faberquisque/syringe-pump/Cableado.pdf

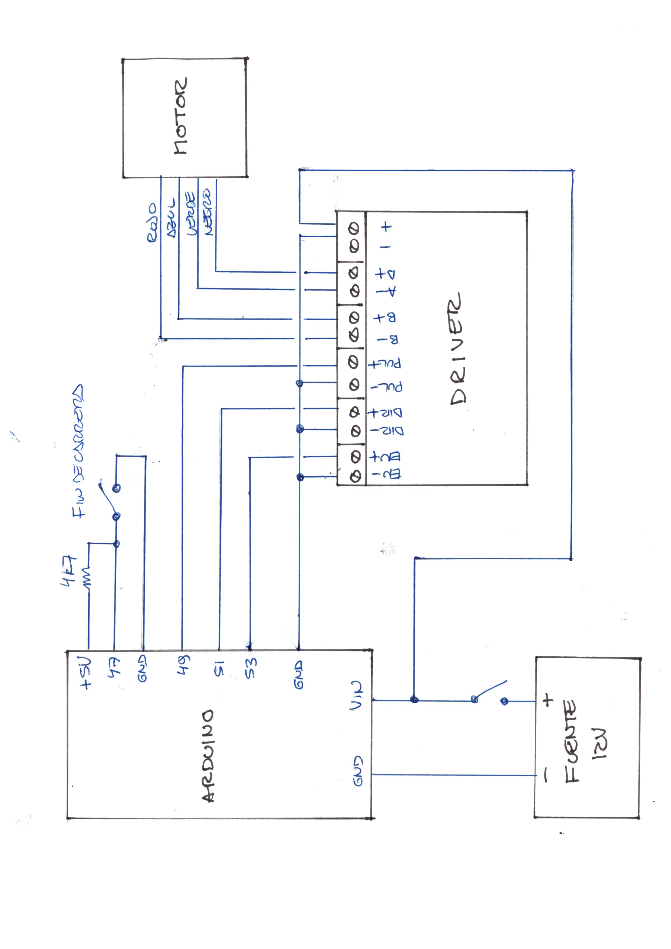
[picture p1: page 1]
