faberquisque/syringe-pump/solid works parts and assembly/SW-case arduino syringe pump/AssemC.SLDASM

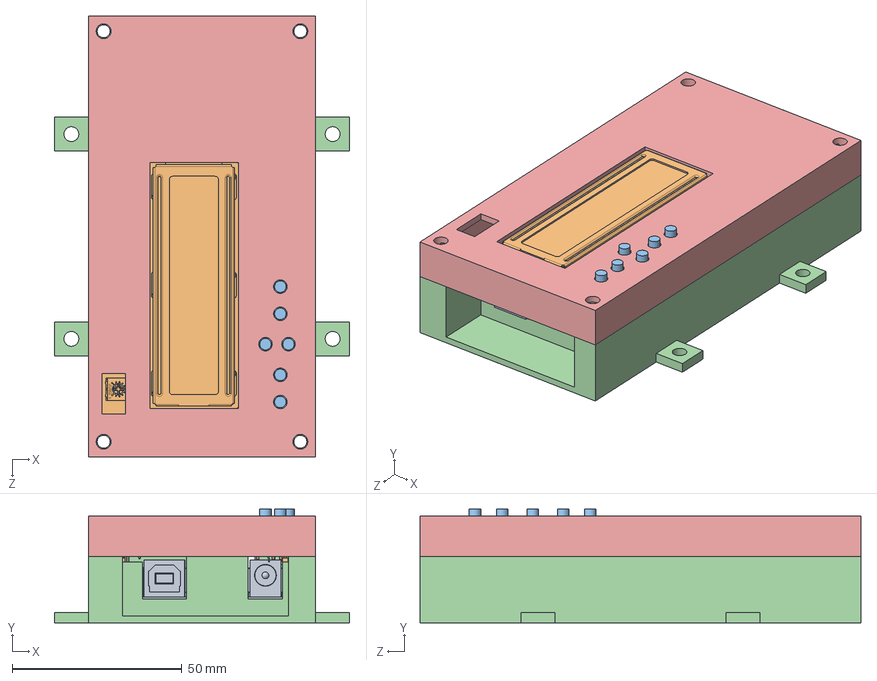
[picture p2: CAD file, 2019-10-16]
solid works parts and assembly/SW-case arduino syringe pump/AssemC.SLDASM
87.0 x 33.5 x 130.0 mm
ArduinoMega
LCD_keypad_Shield_v1-1
boton x 6
arduinocasebaseC
arduinocaseTAPAC
