faberquisque/syringe-pump/solid works parts and assembly/TR08.stp.SLDASM

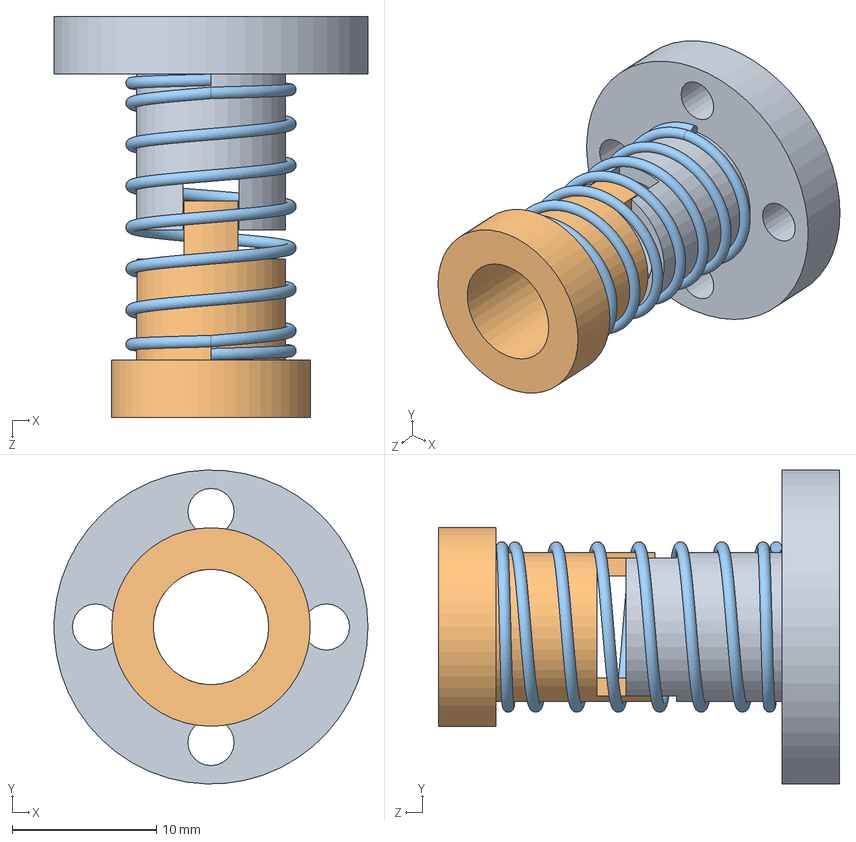
[picture p3: CAD file, 2019-10-15]
solid works parts and assembly/TR08.stp.SLDASM
21.8 x 21.7 x 27.8 mm
nakretka tr08.stp
napinacz nakretki tr8.stp
sprezyna nakretka tr 8.stp
