faberquisque/syringe-pump/solid works parts and assembly/HGW15CA (1).SLDPRT

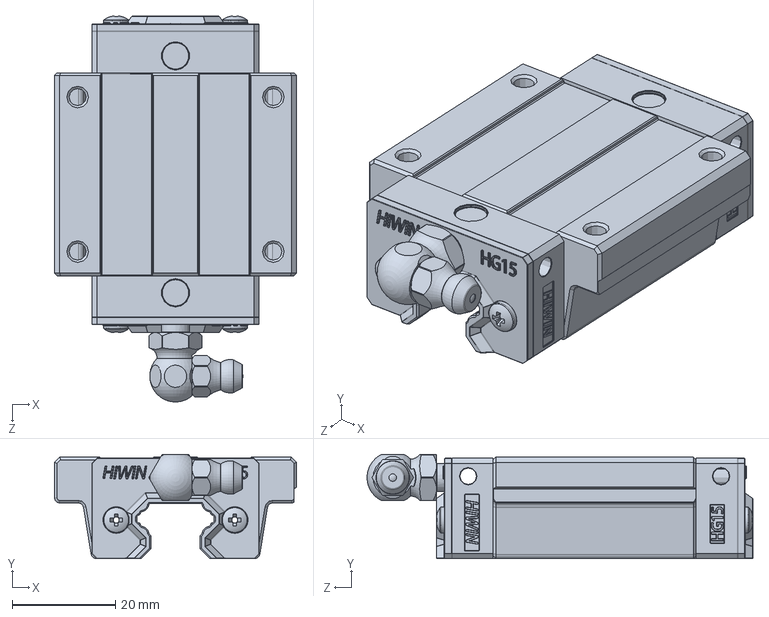
[picture p4: CAD file, 2019-10-16]
solid works parts and assembly/HGW15CA (1).SLDPRT
47.0 x 20.2 x 74.9 mm
