faberquisque/syringe-pump/solid works parts and assembly/Placa base.SLDPRT

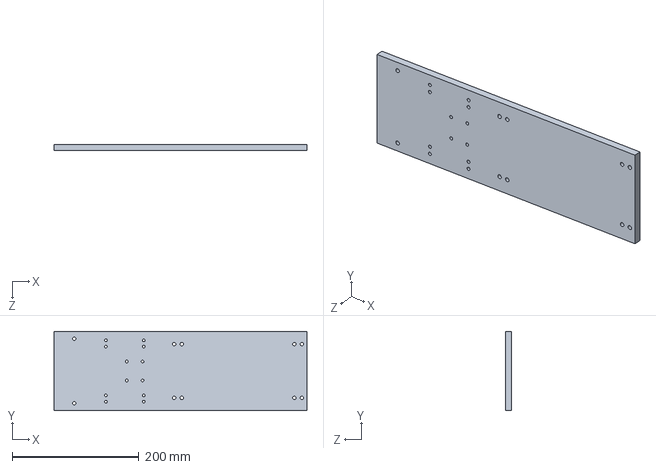
[picture p5: CAD file, 2019-10-16]
solid works parts and assembly/Placa base.SLDPRT
400.0 x 125.0 x 10.0 mm
