faberquisque/syringe-pump/solid works parts and assembly/SW-case arduino syringe pump/arduinocaseTAPAC.SLDPRT

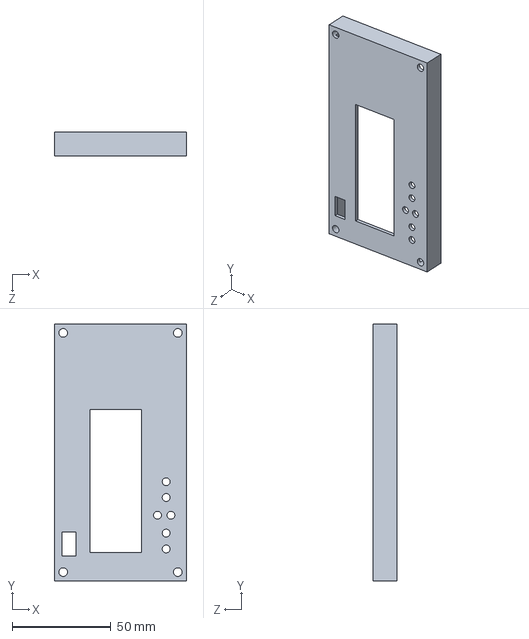
[picture p6: CAD file, 2019-10-16]
solid works parts and assembly/SW-case arduino syringe pump/arduinocaseTAPAC.SLDPRT
67.0 x 130.0 x 12.0 mm
