faberquisque/syringe-pump/solid works parts and assembly/608-2Z.SLDPRT

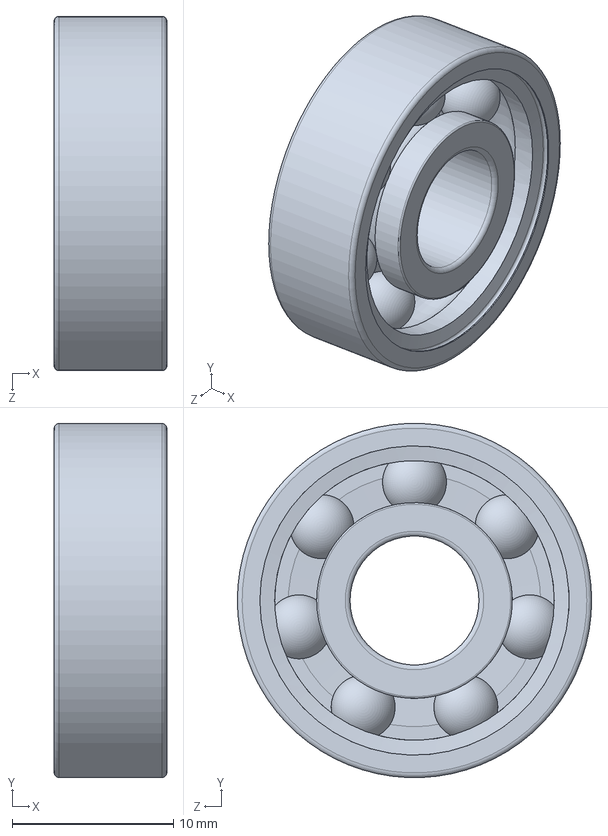
[picture p7: CAD file, 2019-10-16]
solid works parts and assembly/608-2Z.SLDPRT
7.00 x 22.0 x 22.0 mm
