faberquisque/syringe-pump/solid works parts and assembly/SW-case arduino syringe pump/arduinocasebaseC.SLDPRT

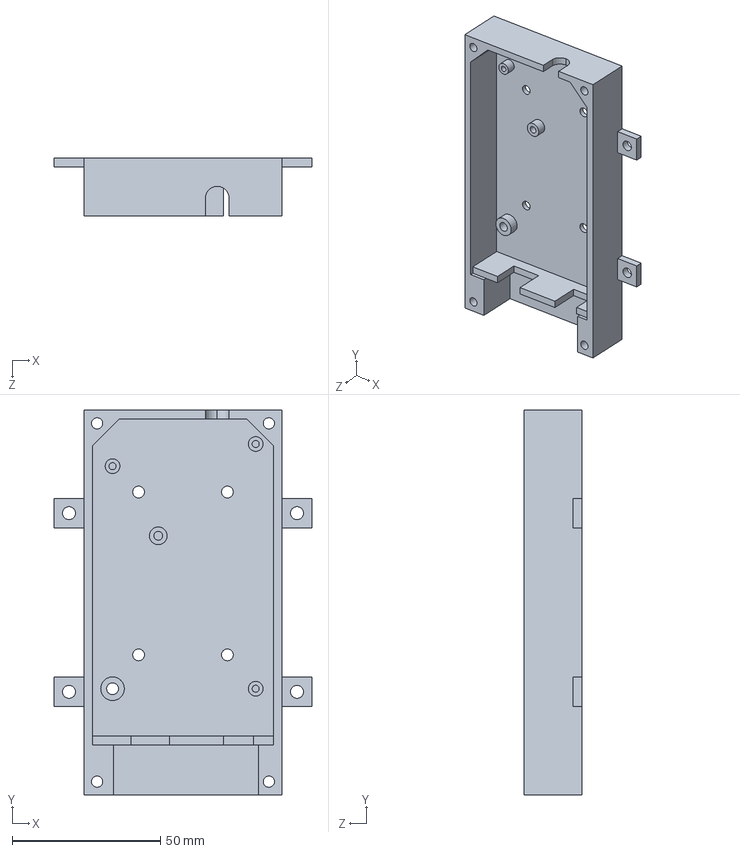
[picture p8: CAD file, 2019-10-16]
solid works parts and assembly/SW-case arduino syringe pump/arduinocasebaseC.SLDPRT
87.0 x 130.0 x 19.5 mm
