faberquisque/syringe-pump/solid works parts and assembly/pushetuerca TR8 para impresion.SLDPRT

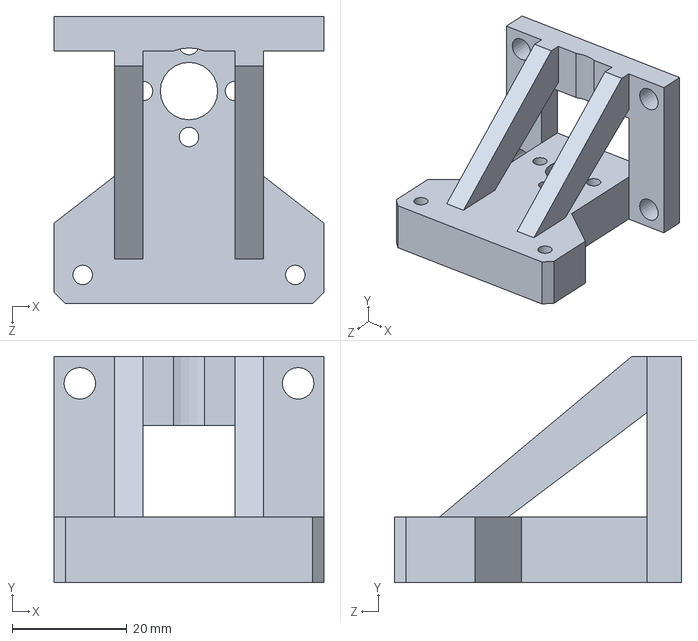
[picture p9: CAD file, 2019-10-16]
solid works parts and assembly/pushetuerca TR8 para impresion.SLDPRT
47.0 x 39.4 x 50.0 mm
