faberquisque/syringe-pump/solid works parts and assembly/SW-case arduino syringe pump/boton.SLDPRT

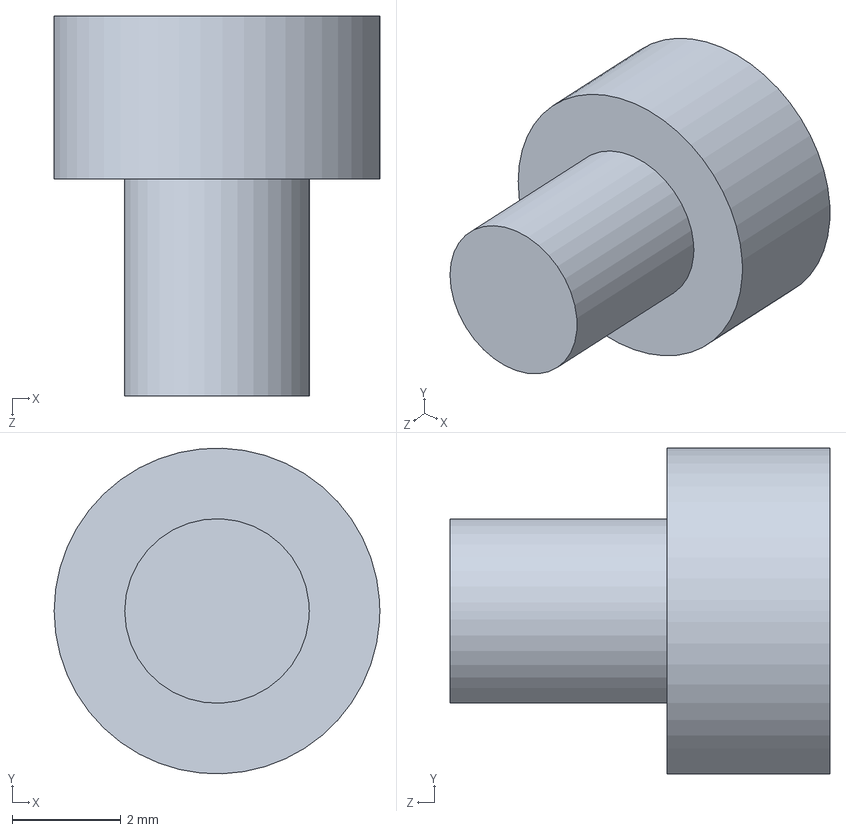
[picture p10: CAD file, 2019-10-16]
solid works parts and assembly/SW-case arduino syringe pump/boton.SLDPRT
6.00 x 6.00 x 7.00 mm
