faberquisque/syringe-pump/solid works parts and assembly/NEMA 17 Motor Mount Plate.SLDPRT

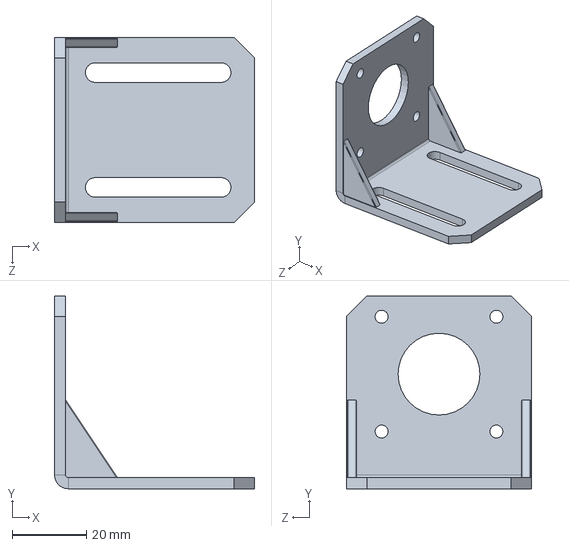
[picture p11: CAD file, 2019-10-16]
solid works parts and assembly/NEMA 17 Motor Mount Plate.SLDPRT
54.0 x 52.0 x 50.0 mm
