faberquisque/syringe-pump/solid works parts and assembly/SW-case arduino syringe pump/ArduinoMega.SLDPRT

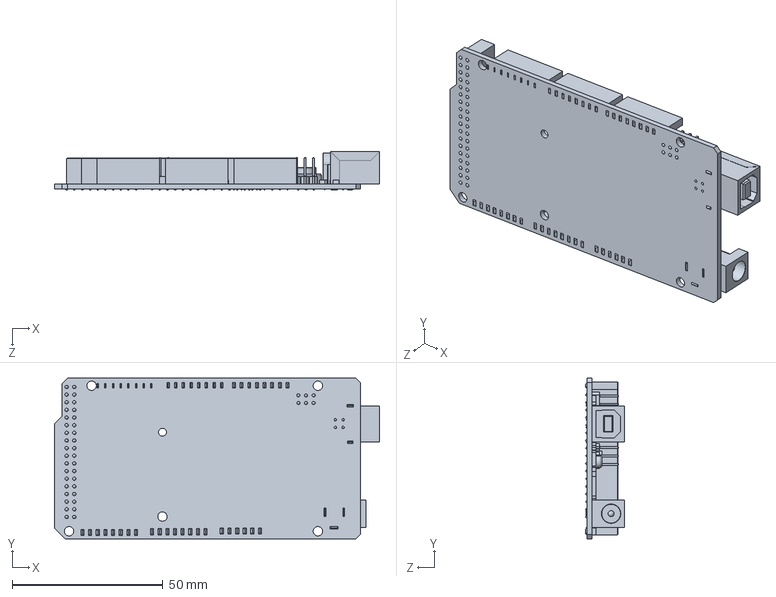
[picture p12: CAD file, 2019-10-16]
solid works parts and assembly/SW-case arduino syringe pump/ArduinoMega.SLDPRT
107.9 x 53.4 x 13.0 mm
