faberquisque/syringe-pump/solid works parts and assembly/NEMA17-PG27b.SLDPRT

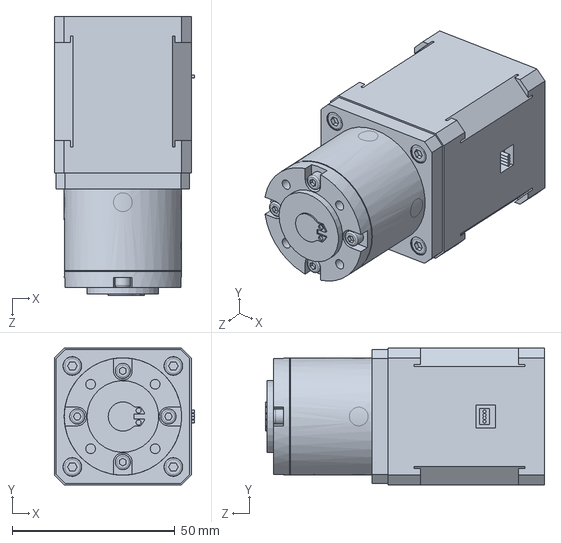
[picture p13: CAD file, 2019-10-16]
solid works parts and assembly/NEMA17-PG27b.SLDPRT
43.0 x 42.0 x 85.6 mm
