faberquisque/syringe-pump/solid works parts and assembly/soporte lado jeringa para impresion.SLDPRT

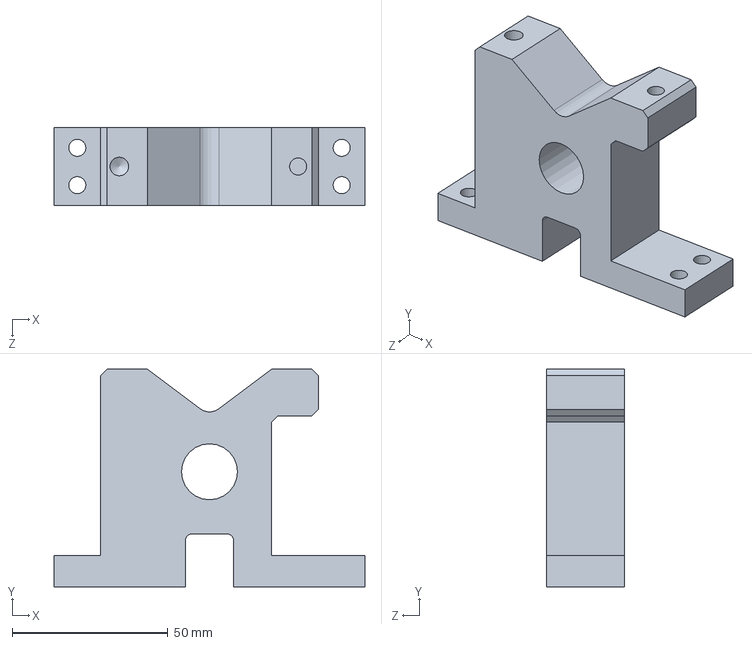
[picture p14: CAD file, 2019-10-16]
solid works parts and assembly/soporte lado jeringa para impresion.SLDPRT
100.0 x 70.0 x 25.0 mm
