faberquisque/syringe-pump/solid works parts and assembly/HGR15T-200mm.SLDPRT

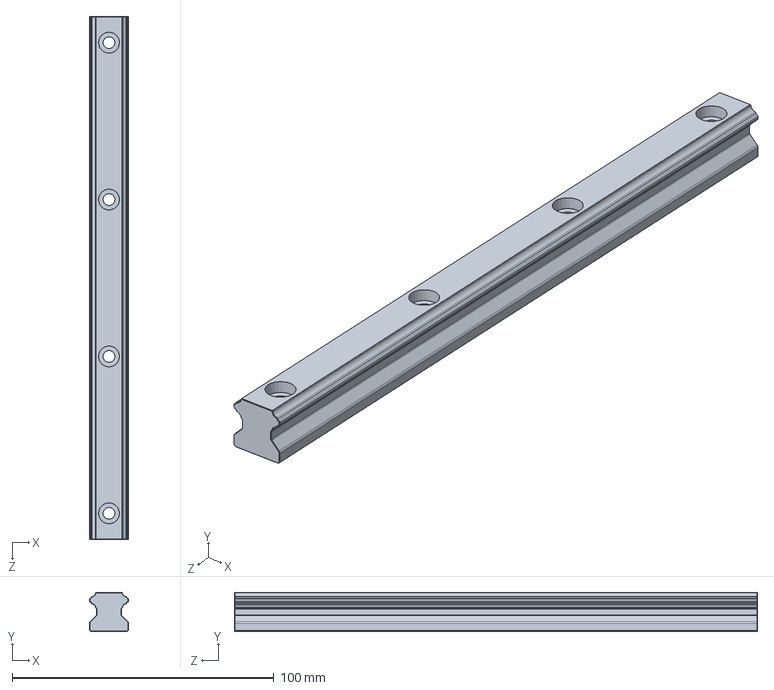
[picture p15: CAD file, 2019-10-16]
solid works parts and assembly/HGR15T-200mm.SLDPRT
15.0 x 15.0 x 200.0 mm
