faberquisque/syringe-pump/solid works parts and assembly/ejereductor.SLDPRT

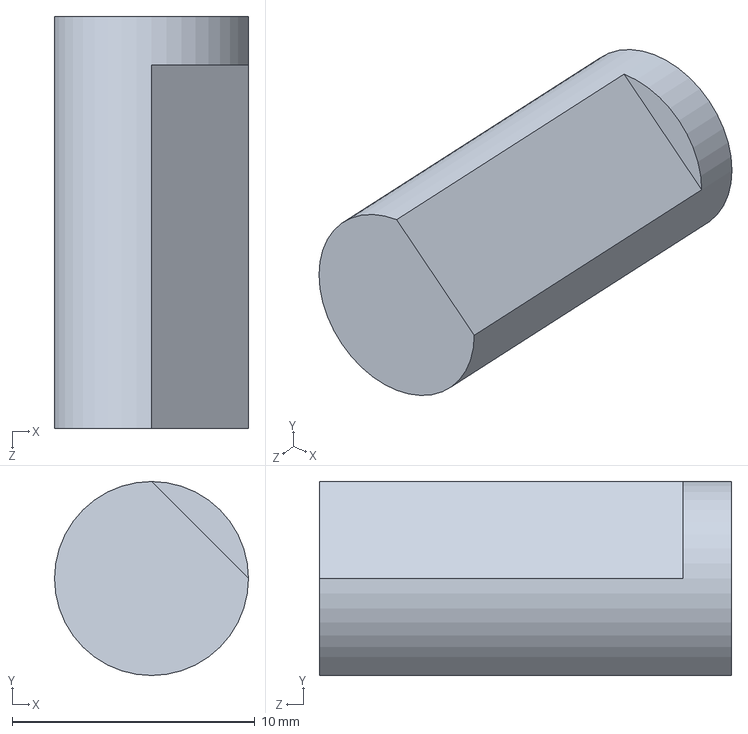
[picture p16: CAD file, 2019-10-16]
solid works parts and assembly/ejereductor.SLDPRT
8.00 x 8.00 x 17.0 mm
