faberquisque/syringe-pump/solid works parts and assembly/soporte lado motor para impresion.SLDPRT

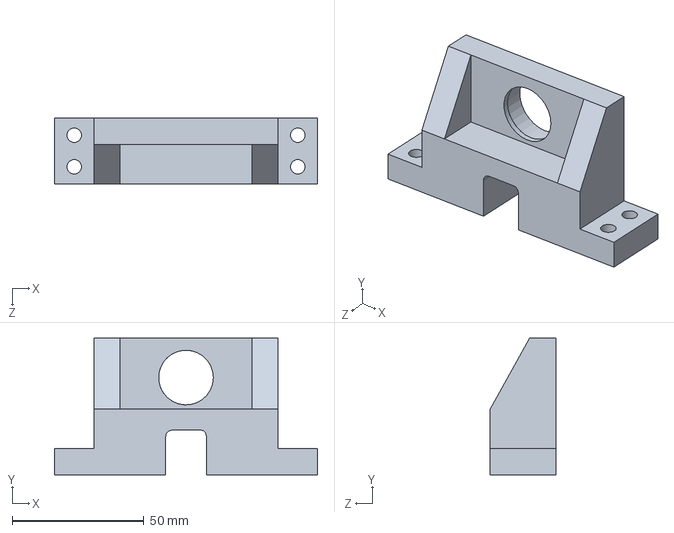
[picture p17: CAD file, 2019-10-16]
solid works parts and assembly/soporte lado motor para impresion.SLDPRT
100.0 x 52.0 x 25.0 mm
