faberquisque/syringe-pump/solid works parts and assembly/base soporte motor.SLDPRT

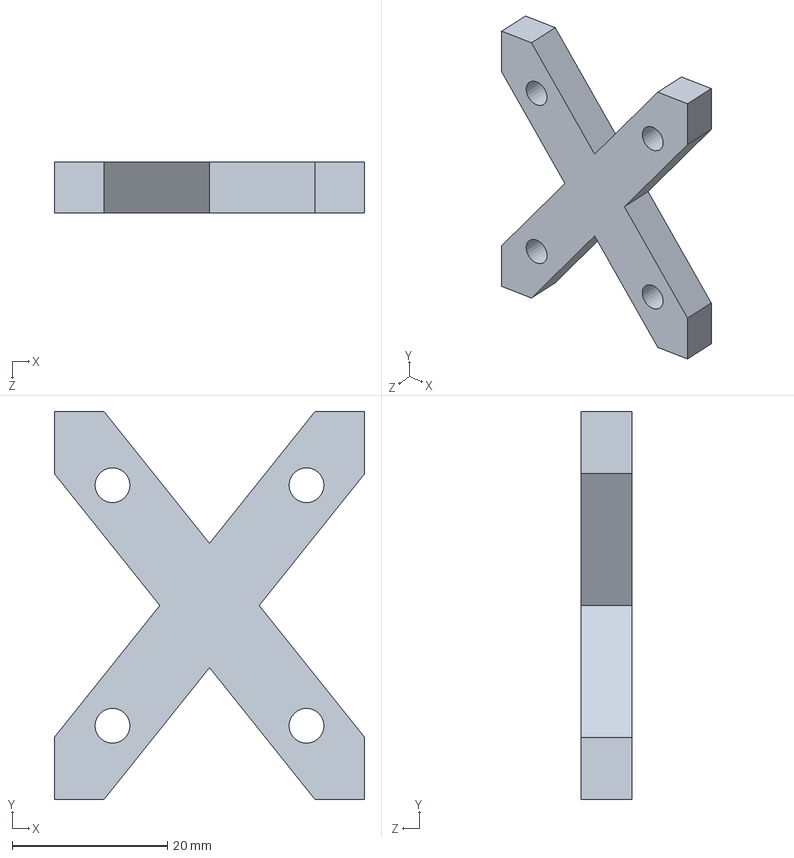
[picture p18: CAD file, 2019-10-16]
solid works parts and assembly/base soporte motor.SLDPRT
40.0 x 50.0 x 6.54 mm
