faberquisque/syringe-pump/solid works parts and assembly/trabajeringa.SLDPRT

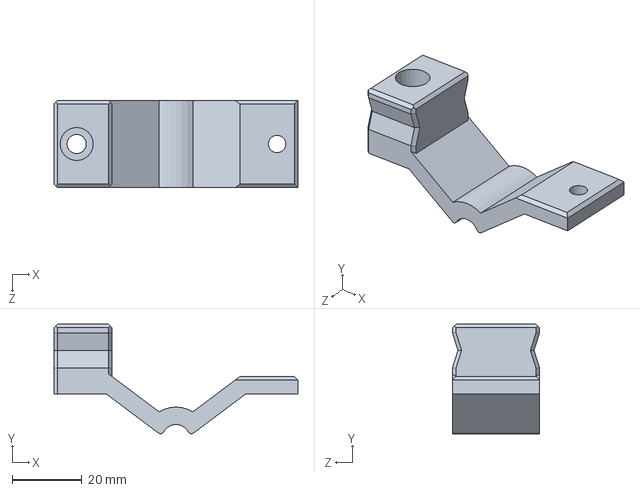
[picture p19: CAD file, 2019-10-16]
solid works parts and assembly/trabajeringa.SLDPRT
70.0 x 31.4 x 25.0 mm
