faberquisque/syringe-pump/solid works parts and assembly/HY-DIV268N-5A.step.SLDPRT

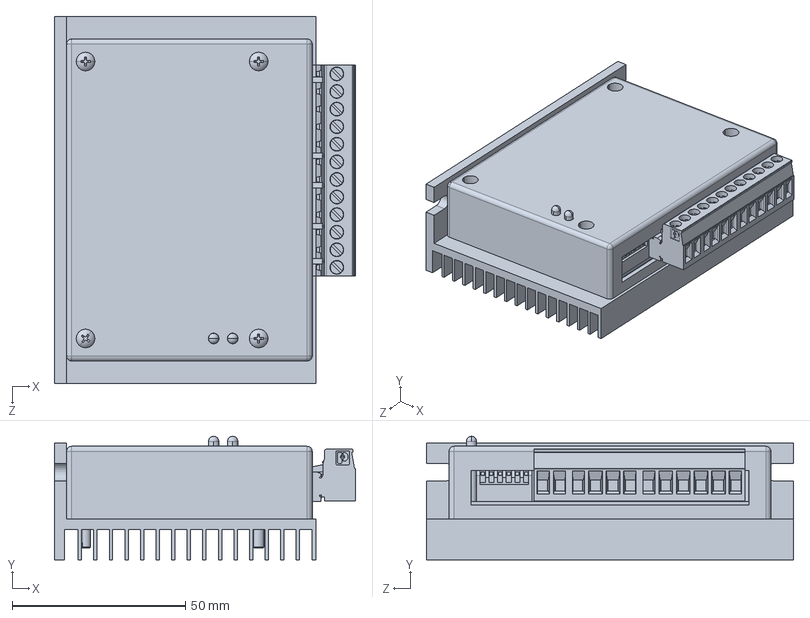
[picture p20: CAD file, 2019-10-16]
solid works parts and assembly/HY-DIV268N-5A.step.SLDPRT
87.0 x 35.7 x 106.0 mm
