faberquisque/syringe-pump/solid works parts and assembly/Pilar.SLDPRT

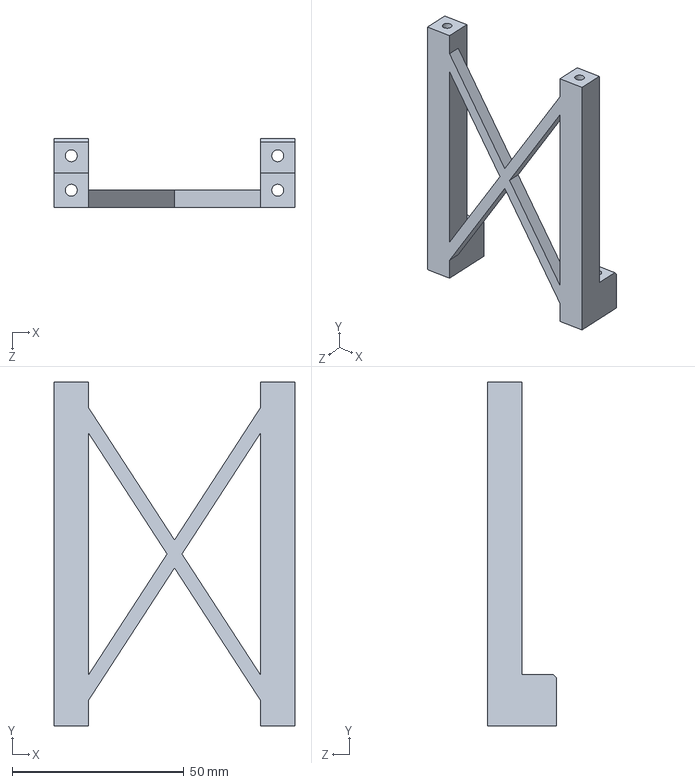
[picture p21: CAD file, 2019-10-16]
solid works parts and assembly/Pilar.SLDPRT
70.0 x 100.0 x 20.0 mm
