faberquisque/syringe-pump/(list of files, cad)

Other CAD files:
solid works parts and assembly/napinacz nakretki tr8.stp.SLDPRT
solid works parts and assembly/nakretka tr08.stp.SLDPRT
solid works parts and assembly/sprezyna nakretka tr 8.stp.SLDPRT
solid works parts and assembly/HY-DIV268N-5A.STEP
solid works parts and assembly/TR08.stp
solid works parts and assembly/9861T533_ALUMINUM HELICAL FLEXIBLE SHAFT COUPLING.STEP
solid works parts and assembly/9861T533_ALUMINUM HELICAL FLEXIBLE SHAFT COUPLING.step.SLDPRT
solid works parts and assembly/HY-DIV268N-5A.SLDPRT
solid works parts and assembly/TR08.SLDPRT
solid works parts and assembly/Trapezoidal lead screw tr8x8-4-L200mm.SLDPRT
