faberquisque/syringe-pump/Calibracion.xlsx

Sheet: Flow Rate
Volumen Jeringa (mL) | Marca | Longitud (mm) | Longitud (um) | Volumen (mL) | Volumen (uL) | Flujo min (mL/min) | Flujo máx (mL/min) | Flujo mín (uL/h) | Flujo máx (uL/h) | Flujo min (nL/min) | Flujo máx (nL/min) | Frecuencia mínima (pulso/seg) | Frecuencia máxima (pulso/paso)
0.01 | Hamilton | 48.04 | 48040 | 0.008 | 8 | 0.000015 | 0.012270 | 0.9 | 736.1990302 | 15.21477996 | 12269.98384 | 31 | 25000
1 | Rymco | 28.10 | 28100 | 0.5 | 500 | 0.001626 | 1.311054 | 97.54244161 | 78663.25936 | 1625.70736 | 1311054.323 | pasos/vuelta motor | vueltaMotor/1vueltaEje (del reductor)
3 | Terumo | 15.86 | 15860 | 1 | 1000 | 0.005761 | 4.645728 | 345.6421954 | 278743.7059 | 5760.703256 | 4645728.432 | 200 | 50.8949
5 | Coronel | 16.34 | 16340 | 2 | 2000 | 0.011183 | 9.018513 | 670.9773829 | 541110.7927 | 11182.95638 | 9018513.211 | Calibración teórica (pulsos/mm) | vuelta Eje (mm)
12 | Terumo | 30.54 | 30540 | 6 | 6000 | 0.017950 | 14.475688 | 1076.991202 | 868541.292 | 17949.85337 | 14475688.2 | 20357.96 | 8
 |  |  |  |  |  |  |  |  |  |  |  | Micro step (pulso/paso) | 16
Multiplicador |  | 16 | pulso/paso |  | 1 | Hz | RPM max (eje) |  | 25 | vuelta eje/min
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
