faberquisque/syringe-pump/solid works parts and assembly/assemblyV2.pdf

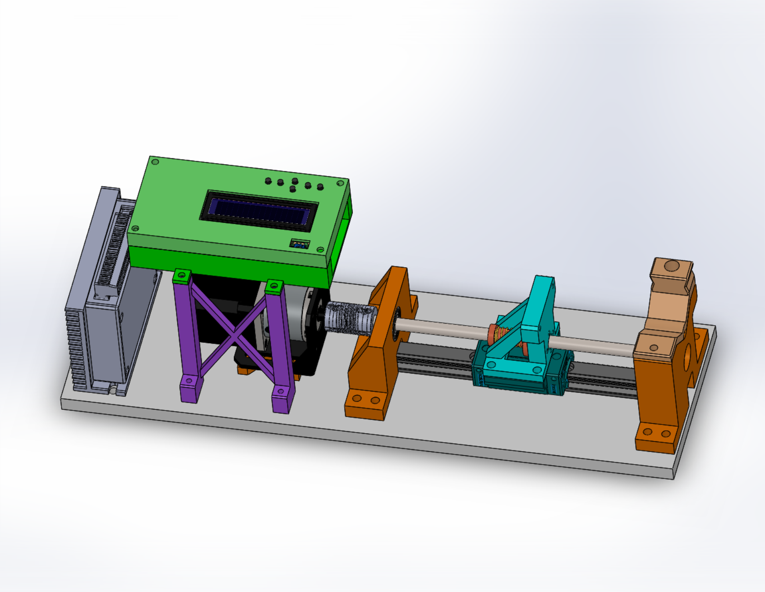
[picture p22: page 1]
