faberquisque/syringe-pump/(list of files, drawings)

Other design files:
Gráfica.opj
