faberquisque/syringe-pump/(commit log)

2019-10-15 Estado actual de 2 bombas
    [608-2Z.SLDPRT, 9861T533_ALUMINUM HELICAL FLEXIBLE SHAFT COUPLING.STEP, 9861T533_ALUMINUM HELICAL FLEXIBLE SHAFT COUPLING.step.SLDPRT, ArduinoMega.SLDPRT, AssemC.SLDASM, HGR15T-200mm.SLDPRT, HGW15CA (1).SLDPRT, HY-DIV268N-5A.STEP]
2019-10-16 .stp mal colocados: corregidos
    [608-2Z.SLDPRT, 9861T533_ALUMINUM HELICAL FLEXIBLE SHAFT COUPLING.step.SLDPRT, ArduinoMega.SLDPRT, AssemC.SLDASM, HGR15T-200mm.SLDPRT, HGW15CA (1).SLDPRT, HY-DIV268N-5A.SLDPRT, HY-DIV268N-5A.step.SLDPRT]
2019-10-17 Calculo flujo min/max
    [Flow rate.xlsx]
2019-10-18 Multiplicador 16 pulso/paso
    #define MAX_FREQ 25000
    unsigned long calibration = 20358
    [Flow rate.xlsx]
2019-10-18 Flow rate
    [Flow rate.xlsx]
2019-10-18 Calibración
    [Calibracion.xlsx]
2019-11-22 ultimo punto
    [Calibracion.xlsx]
2019-11-22 cambio excel
    [Calibracion.xlsx, Flow rate.xlsx]
2019-11-26 Calib bomba 2
    [Calibracion.xlsx]
2019-12-02 Le s. pump 2
    [Calibracion.xlsx]
2019-12-02 Compilado y carga de datos a la bomba 1
    20381 pulsos/mm
    syringeLenght 45252
    syringeVolume 3000
    [Calibracion.xlsx]
2019-12-03 Curva de calibracion bomba 1
    [Calibracion.xlsx, Gráfica.opj]
2020-02-04 Calculos de flujos de prueba de chip
    [Calibracion.xlsx]
2020-02-10 Simplificacion de funciones de start y stop
    Tested!
